ch98-1/Thermocouple-Data-Logger/README.md

# Thermocouple-Data-Logger
Thermocouple Data Logger using MAX31856 and ATmega324PA

Warning: Do not put this device anywhere near lawyers, as it may permanently cease to function if you do so.

**License**

All files are licensed under [zlib license](https://opensource.org/licenses/Zlib) unless noted otherwise.
KiCad Library Files (All .lib .dcm .bck and .pretty files in The Thermocouple-Data-Logger directory) are licensed under [KiCad Libraries License] (http://kicad-pcb.org/libraries/license/)
Petit FatFs Module (All files in /Firmware/pff3) is licensed under Petit FatFs License
