ch98-1/Thermocouple-Data-Logger/Thermocouple Data Logger.pdf

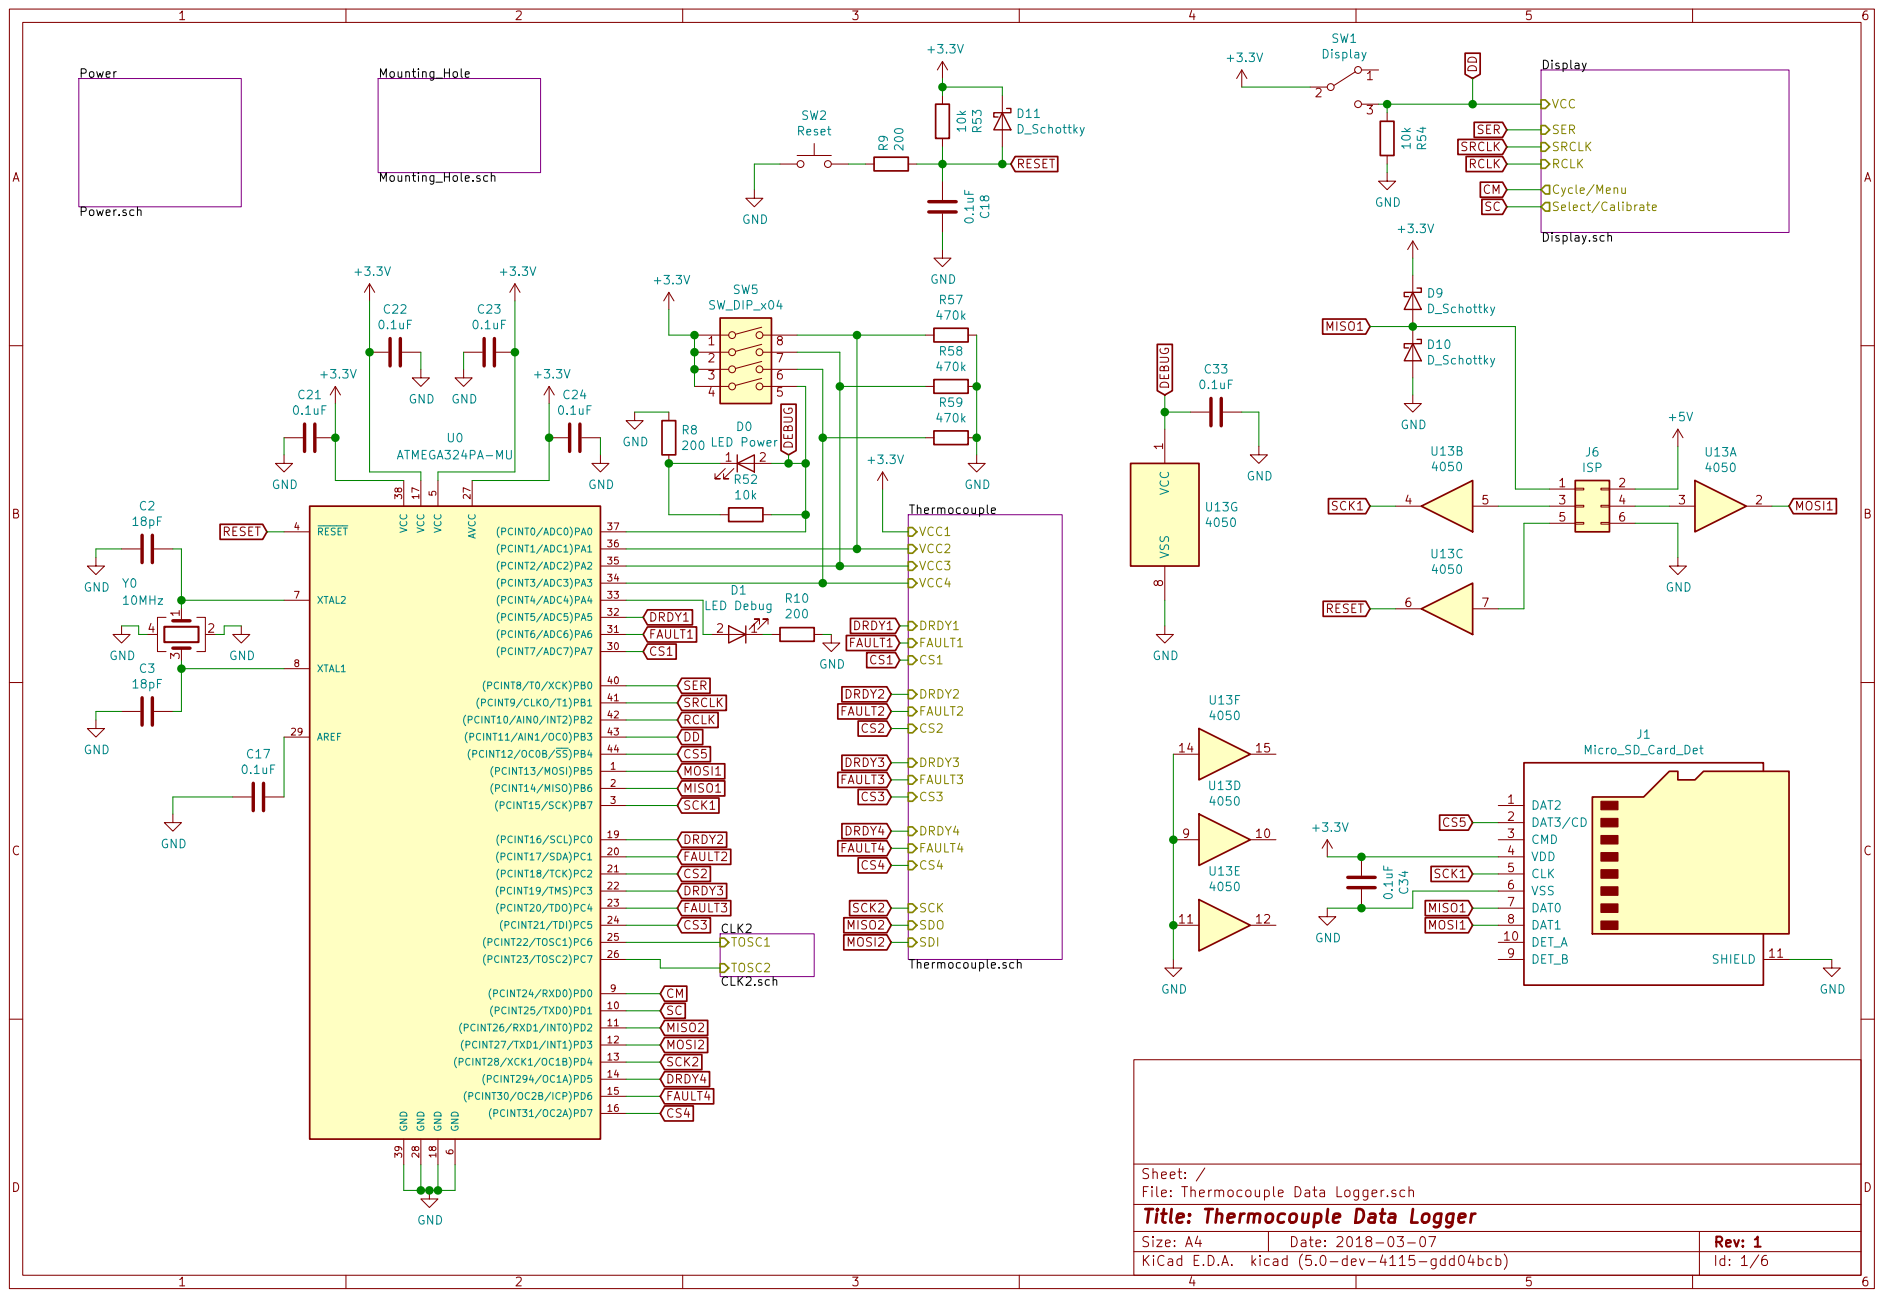
[picture p1: page 1]

SRCLK RCLK DD
Display.sch VCC
Select/Calibrate Cycle/Menu SER
SRCLK RCLK

File: Thermocouple Data Logger.sch Sheet: /
Id: 1/6 Title: Thermocouple Data Logger

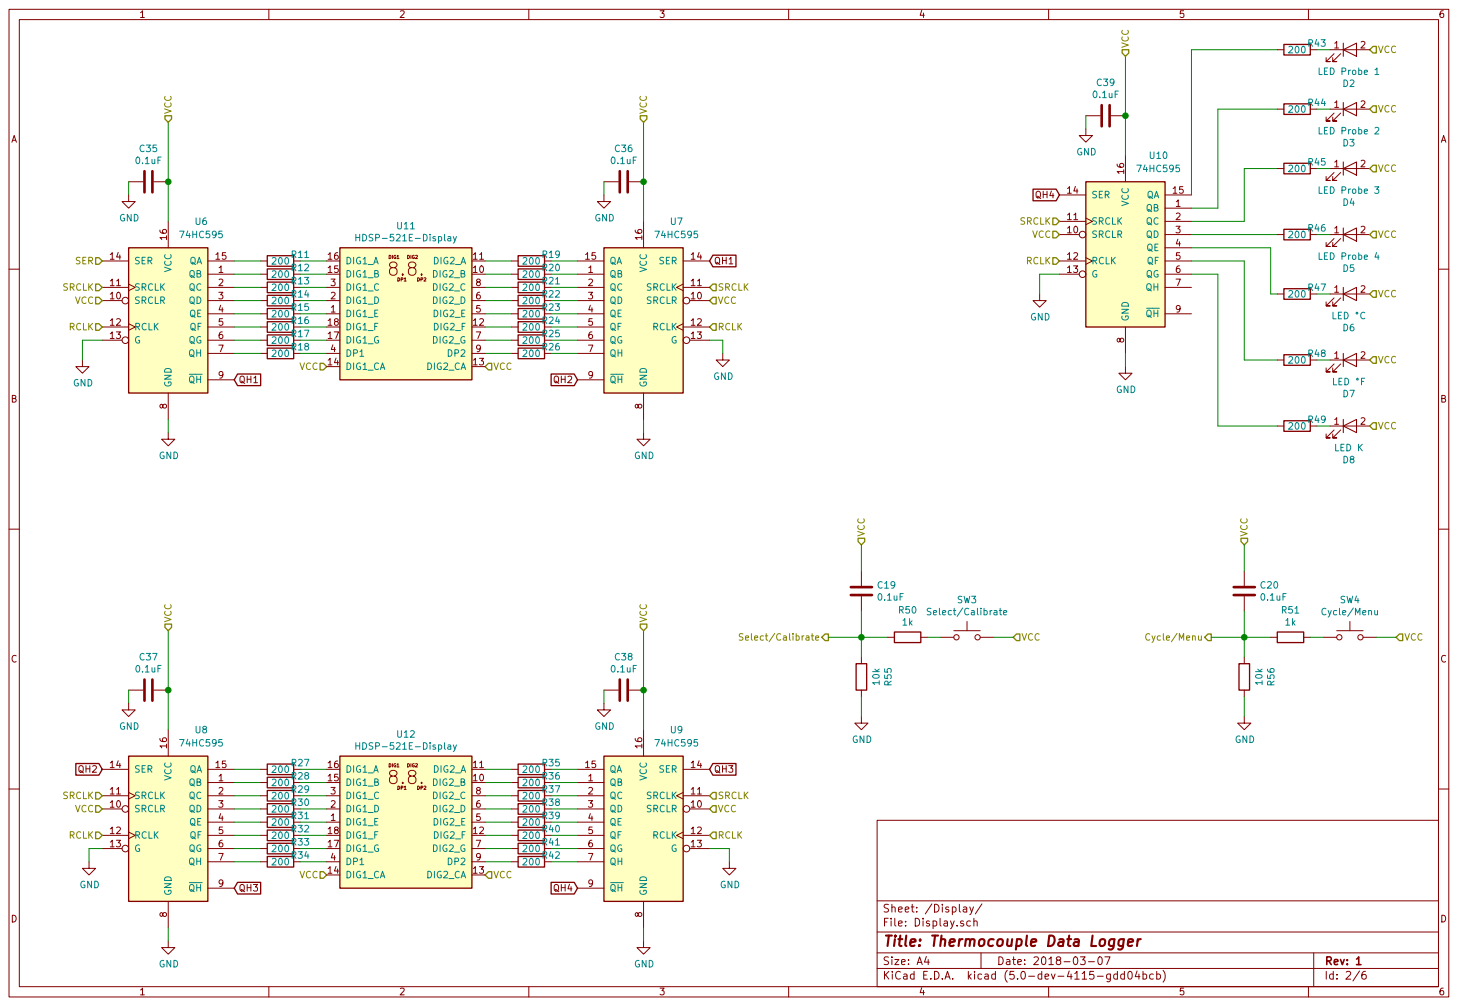
[picture p2: page 2]

8 QH 9 SRCLR 10 SRCLK 11 RCLK 12 G
VCC GND

Sheet: /Display/
File: Display.sch
Id: 2/6 Title: Thermocouple Data Logger

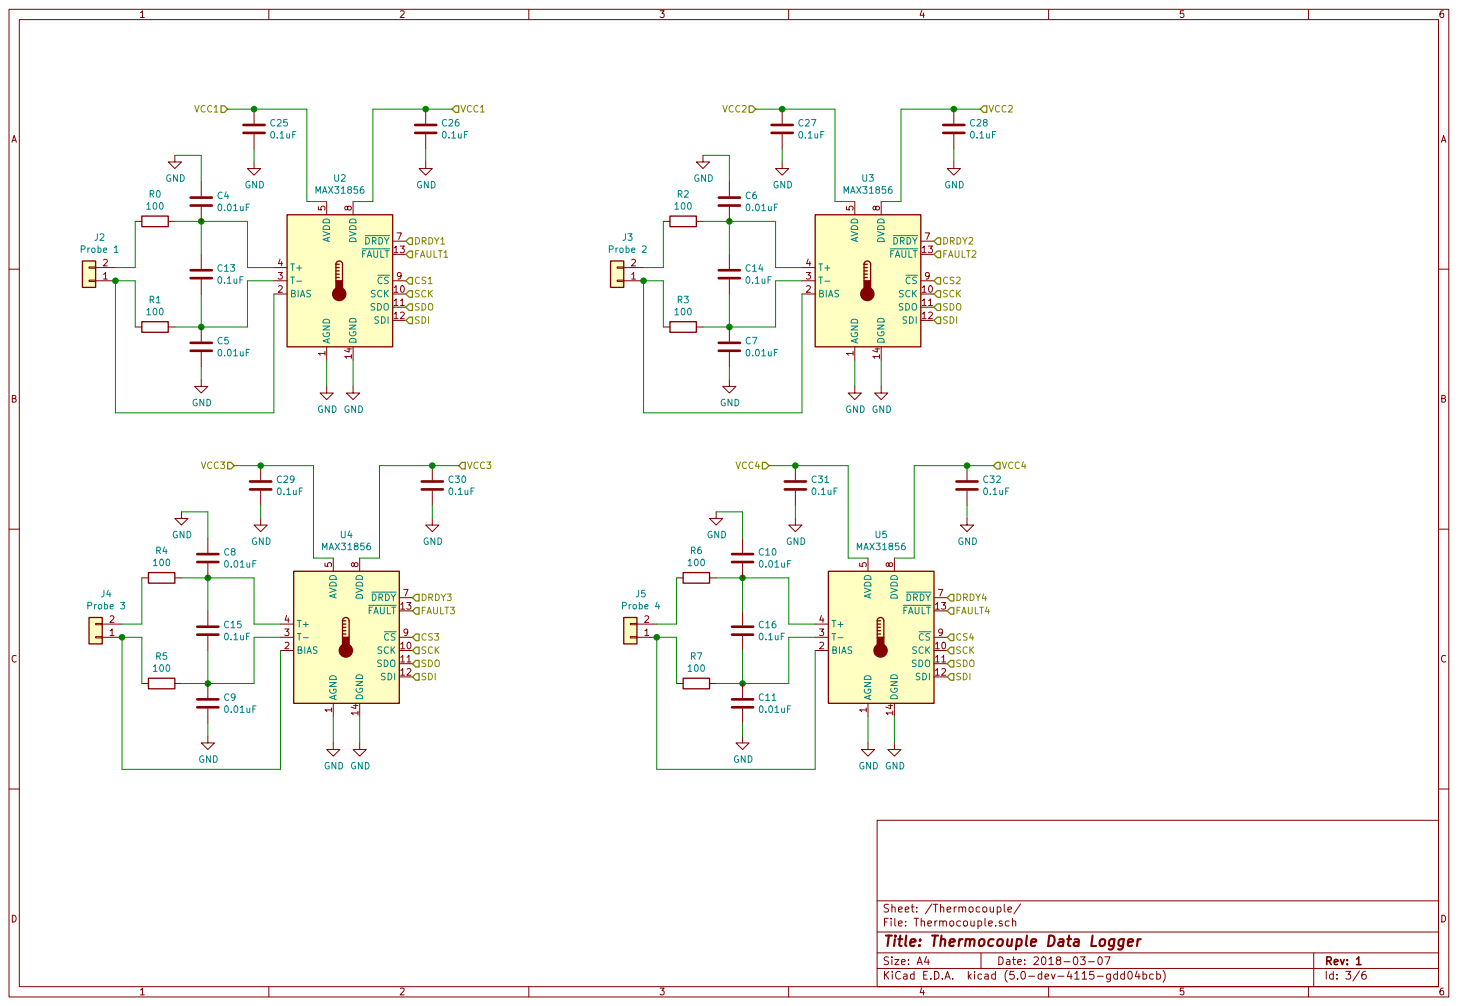
[picture p3: page 3]

8 CS 9 SCK 10 SDO 11 SDI 12 FAULT 13 DGND 14 U2 MAX31856 GND GND

8 CS 9 SCK 10 SDO 11 SDI 12 FAULT 13 DGND 14 U3 MAX31856 GND GND
SDI AGND

8 CS 9 SCK 10 SDO 11 SDI 12 FAULT 13 DGND 14 U4 MAX31856 GND GND

8 CS 9 SCK 10 SDO 11 SDI 12 FAULT 13 DGND 14 U5 MAX31856 GND GND

File: Thermocouple.sch
Id: 3/6 Title: Thermocouple Data Logger

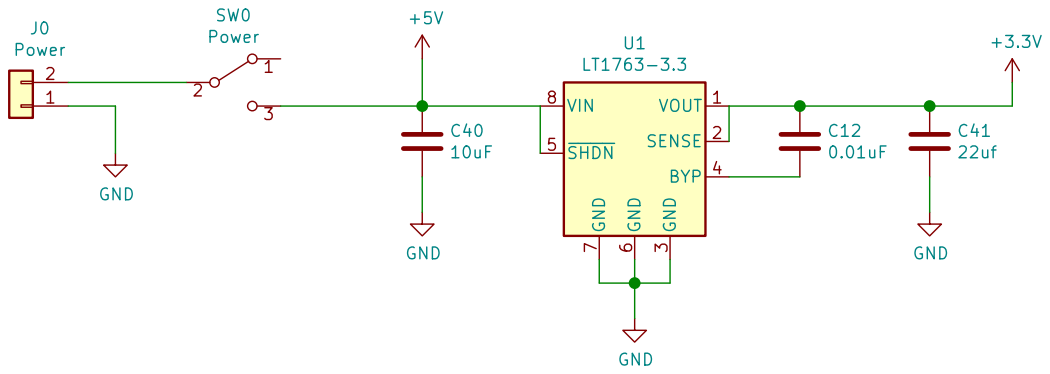
[picture p4: page 4]

Id: 4/6 Title: Thermocouple Data Logger File: Power.sch Sheet: /Power/

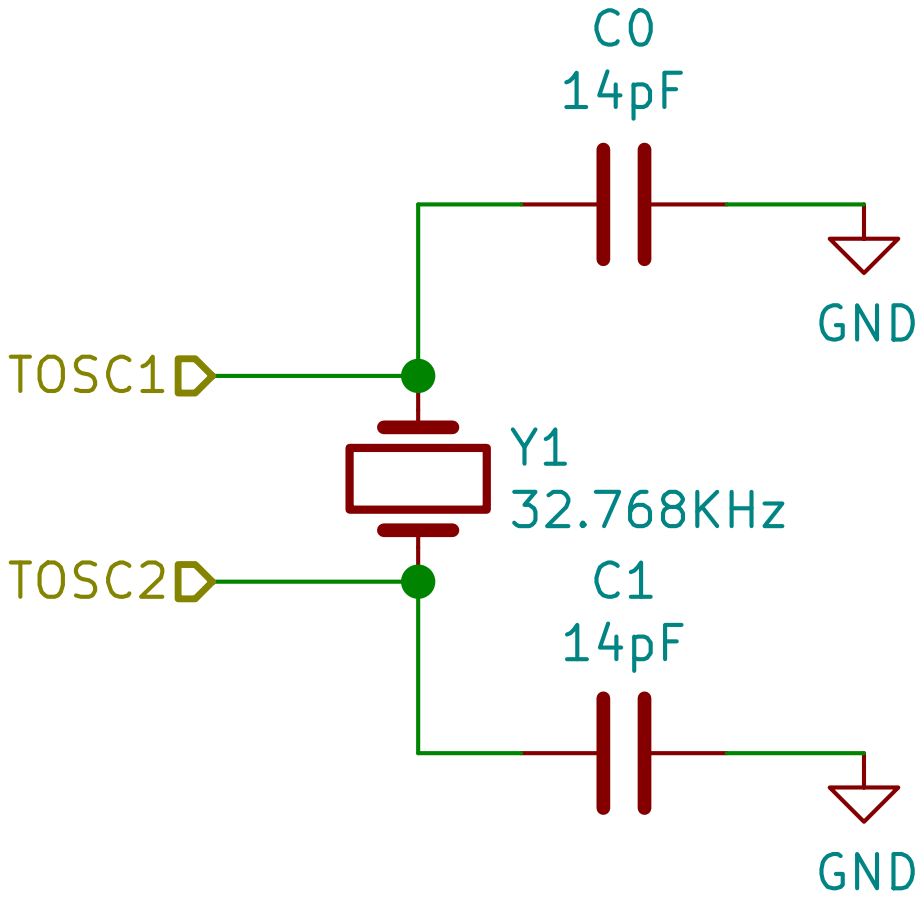
[picture p5: page 5]

Id: 5/6 Title: Thermocouple Data Logger File: CLK2.sch Sheet: /CLK2/

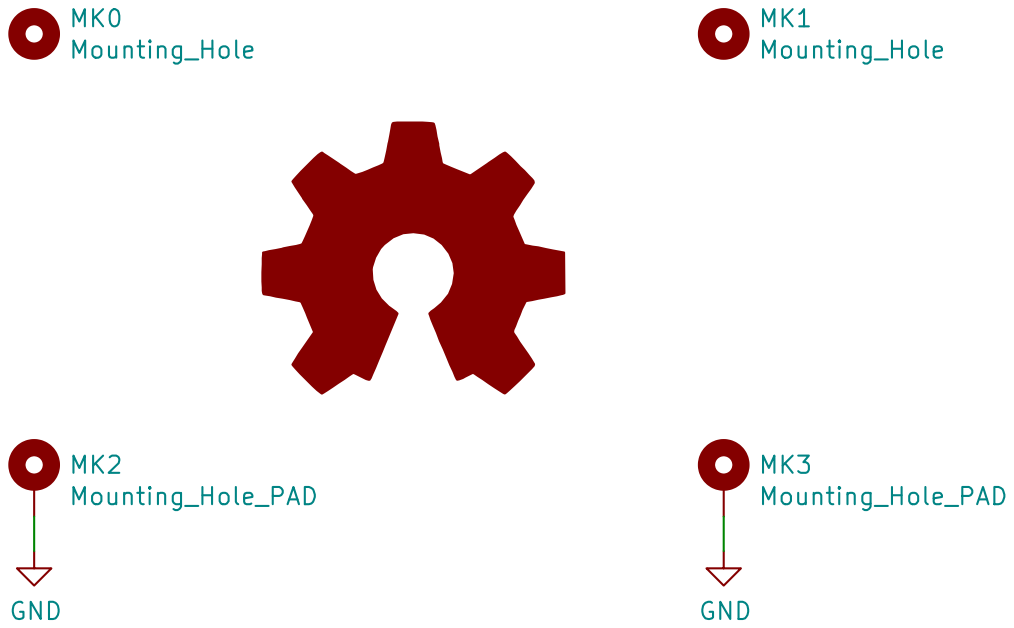
[picture p6: page 6]

File: Mounting_Hole.sch
Id: 6/6 Title: Thermocouple Data Logger
