ch98-1/Thermocouple-Data-Logger/Thermocouple-Data-Logger/Thermocouple Data Logger.kicad_pcb

## KiCad design Thermocouple-Data-Logger/Thermocouple Data Logger.kicad_pcb (2018-04-28)

Schematic: Thermocouple Data Logger.sch

Parts:
C2, C3: 18pF; C_0402
C17, C18, C21, C22, C23, C24, C33, C34: 0.1uF; C_0402
D0: LED Power; LED_0603
D1: LED Debug; LED_0603
D9, D10, D11: D_Schottky; D_SOD-323
J1: Micro_SD_Card_Det; Hirose_DM3BT-DSF-PEJS
J6: ISP; Pin_Header_Straight_2x03_Pitch2.54mm
R8, R9, R10: 200; R_0805
R52, R53, R54: 10k; R_0402
R57, R58, R59: 470k; R_0402
SW1: Display; SW_SPDT_CK-JS102011SAQN
SW2: Reset; SW_SPST_PTS645
SW5: SW_DIP_x04; SW_DIP_x4_W5.08mm_Slide_Copal_CHS-A
U0: ATMEGA324PA-MU; TQFP-44_10x10mm_Pitch0.8mm
U13: 4050; TSSOP-16_4.4x5mm_Pitch0.65mm
Y0: 10MHz; Crystal_SMD_Abracon_ABM3B-4pin_5.0x3.2mm

Connections:
+3V3: C21.1, C22.2, C23.1, C24.2, C34.2, D9.1 (K), D11.1 (K), J1.4 (VDD), R53.2, SW1.2, SW5.1, SW5.2, SW5.3, SW5.4, U0.5 (VCC), U0.17 (VCC), U0.27 (AVCC), U0.38 (VCC); also elsewhere on the board
+5V: J6.2; also elsewhere on the board
/CLK2/TOSC1: U0.25 ((PCINT22/TOSC1)PC6); also elsewhere on the board
/CLK2/TOSC2: U0.26 ((PCINT23/TOSC2)PC7); also elsewhere on the board
/Thermocouple/VCC2: R57.2, SW5.8, U0.36 ((PCINT1/ADC1)PA1); also elsewhere on the board
/Thermocouple/VCC3: R58.2, SW5.7, U0.35 ((PCINT2/ADC2)PA2); also elsewhere on the board
/Thermocouple/VCC4: R59.2, SW5.6, U0.34 ((PCINT3/ADC3)PA3); also elsewhere on the board
CM: U0.9 ((PCINT24/RXD0)PD0); also elsewhere on the board
CS1: U0.30 ((PCINT7/ADC7)PA7); also elsewhere on the board
CS2: U0.21 ((PCINT18/TCK)PC2); also elsewhere on the board
CS3: U0.24 ((PCINT21/TDI)PC5); also elsewhere on the board
CS4: U0.16 ((PCINT31/OC2A)PD7); also elsewhere on the board
CS5: J1.2 (DAT3/CD), U0.44 ((PCINT12/OC0B/~SS~)PB4)
DD: R54.2, SW1.3, U0.43 ((PCINT11/AIN1/OC0)PB3); also elsewhere on the board
DEBUG: C33.2, D0.2 (A), R52.1, SW5.5, U0.37 ((PCINT0/ADC0)PA0), U13.1 (VCC)
DRDY1: U0.32 ((PCINT5/ADC5)PA5); also elsewhere on the board
DRDY2: U0.19 ((PCINT16/SCL)PC0); also elsewhere on the board
DRDY3: U0.22 ((PCINT19/TMS)PC3); also elsewhere on the board
DRDY4: U0.14 ((PCINT294/OC1A)PD5); also elsewhere on the board
FAULT1: U0.31 ((PCINT6/ADC6)PA6); also elsewhere on the board
FAULT2: U0.20 ((PCINT17/SDA)PC1); also elsewhere on the board
FAULT3: U0.23 ((PCINT20/TDO)PC4); also elsewhere on the board
FAULT4: U0.15 ((PCINT30/OC2B/ICP)PD6); also elsewhere on the board
MISO1: D9.2 (A), D10.1 (K), J1.7 (DAT0), J6.1, U0.2 ((PCINT14/MISO)PB6)
MISO2: U0.11 ((PCINT26/RXD1/INT0)PD2); also elsewhere on the board
MOSI1: J1.8 (DAT1), U0.1 ((PCINT13/MOSI)PB5), U13.2
MOSI2: U0.12 ((PCINT27/TXD1/INT1)PD3); also elsewhere on the board
unnamed: C2.1, U0.7 (XTAL2), Y0.1
unnamed: C3.1, U0.8 (XTAL1), Y0.3
unnamed: C17.1, U0.29 (AREF)
unnamed: D0.1 (K), R8.2, R52.2
unnamed: D1.1 (K), R10.1
unnamed: D1.2 (A), U0.33 ((PCINT4/ADC4)PA4)
unnamed: J6.3, U13.5
unnamed: J6.4, U13.3
unnamed: J6.5, U13.7
unnamed: R9.1, SW2.2
RCLK: U0.42 ((PCINT10/AIN0/INT2)PB2); also elsewhere on the board
RESET: C18.2, D11.2 (A), R9.2, R53.1, U0.4 (~RESET), U13.6
SC: U0.10 ((PCINT25/TXD0)PD1); also elsewhere on the board
SCK1: J1.5 (CLK), U0.3 ((PCINT15/SCK)PB7), U13.4
SCK2: U0.13 ((PCINT28/XCK1/OC1B)PD4); also elsewhere on the board
SER: U0.40 ((PCINT8/T0/XCK)PB0); also elsewhere on the board
SRCLK: U0.41 ((PCINT9/CLKO/T1)PB1); also elsewhere on the board

Schematic: Display.sch, Thermocouple Data Logger

Parts:
C19, C20, C35, C36, C37, C38, C39: 0.1uF; C_0402
D2: LED Probe 1; LED_0603
D3: LED Probe 2; LED_0603
D4: LED Probe 3; LED_0603
D5: LED Probe 4; LED_0603
D6: LED °C; LED_0603
D7: LED °F; LED_0603
D8: LED K; LED_0603
R11, R12, R13, R14, R15, R16, R17, R18, R19, R20, R21, R22, R23, R24, R25, R26, R27, R28, R29, R30, R31, R32, R33, R34, R35, R36, R37, R38, R39, R40, R41, R42, R43, R44, R45, R46, R47, R48, R49: 200; R_0805
R50, R51: 1k; R_0402
R55, R56: 10k; R_0402
SW3: Select/Calibrate; SW_SPST_PTS645
SW4: Cycle/Menu; SW_SPST_PTS645
U6, U7, U8, U9, U10: 74HC595; TSSOP-16_4.4x5mm_Pitch0.65mm
U11, U12: HDSP-521E-Display; HDSP-521E

Connections:
CM: C20.2, R51.2, R56.2; also elsewhere on the board
DD: C19.1, C20.1, C35.1, C36.1, C37.1, C38.1, C39.1, D2.2 (A), D3.2 (A), D4.2 (A), D5.2 (A), D6.2 (A), D7.2 (A), D8.2 (A), SW3.2, SW4.2, U6.10 (SRCLR), U6.16 (VCC), U7.10 (SRCLR), U7.16 (VCC), U8.10 (SRCLR), U8.16 (VCC), U9.10 (SRCLR), U9.16 (VCC), U10.10 (SRCLR), U10.16 (VCC), U11.13, U11.14, U12.13, U12.14; also elsewhere on the board
unnamed: D2.1 (K), R43.1
unnamed: D3.1 (K), R44.1
unnamed: D4.1 (K), R45.1
unnamed: D5.1 (K), R46.1
unnamed: D6.1 (K), R47.1
unnamed: D7.1 (K), R48.1
unnamed: D8.1 (K), R49.1
unnamed: R11.1, U11.16
unnamed: R11.2, U6.15 (QA)
unnamed: R12.1, U11.15
unnamed: R12.2, U6.1 (QB)
unnamed: R13.1, U11.3
unnamed: R13.2, U6.2 (QC)
unnamed: R14.1, U11.2
unnamed: R14.2, U6.3 (QD)
unnamed: R15.1, U11.1
unnamed: R15.2, U6.4 (QE)
unnamed: R16.1, U11.18
unnamed: R16.2, U6.5 (QF)
unnamed: R17.1, U11.17
unnamed: R17.2, U6.6 (QG)
unnamed: R18.1, U11.4
unnamed: R18.2, U6.7 (QH)
unnamed: R19.1, U7.15 (QA)
unnamed: R19.2, U11.11
unnamed: R20.1, U7.1 (QB)
unnamed: R20.2, U11.10
unnamed: R21.1, U7.2 (QC)
unnamed: R21.2, U11.8
unnamed: R22.1, U7.3 (QD)
unnamed: R22.2, U11.6
unnamed: R23.1, U7.4 (QE)
unnamed: R23.2, U11.5
unnamed: R24.1, U7.5 (QF)
unnamed: R24.2, U11.12
unnamed: R25.1, U7.6 (QG)
unnamed: R25.2, U11.7
unnamed: R26.1, U7.7 (QH)
unnamed: R26.2, U11.9
unnamed: R27.1, U12.16
unnamed: R27.2, U8.15 (QA)
unnamed: R28.1, U12.15
unnamed: R28.2, U8.1 (QB)
unnamed: R29.1, U12.3
unnamed: R29.2, U8.2 (QC)
unnamed: R30.1, U12.2
unnamed: R30.2, U8.3 (QD)
unnamed: R31.1, U12.1
unnamed: R31.2, U8.4 (QE)
unnamed: R32.1, U12.18
unnamed: R32.2, U8.5 (QF)
unnamed: R33.1, U12.17
unnamed: R33.2, U8.6 (QG)
unnamed: R34.1, U12.4
unnamed: R34.2, U8.7 (QH)
unnamed: R35.1, U9.15 (QA)
unnamed: R35.2, U12.11
unnamed: R36.1, U9.1 (QB)
unnamed: R36.2, U12.10
unnamed: R37.1, U9.2 (QC)
unnamed: R37.2, U12.8
unnamed: R38.1, U9.3 (QD)
unnamed: R38.2, U12.6
unnamed: R39.1, U9.4 (QE)
unnamed: R39.2, U12.5
unnamed: R40.1, U9.5 (QF)
unnamed: R40.2, U12.12
unnamed: R41.1, U9.6 (QG)
unnamed: R41.2, U12.7
unnamed: R42.1, U9.7 (QH)
unnamed: R42.2, U12.9
unnamed: R43.2, U10.15 (QA)
unnamed: R44.2, U10.1 (QB)
unnamed: R45.2, U10.2 (QC)
unnamed: R46.2, U10.3 (QD)
unnamed: R47.2, U10.4 (QE)
unnamed: R48.2, U10.5 (QF)
unnamed: R49.2, U10.6 (QG)
unnamed: R50.1, SW3.1
unnamed: R51.1, SW4.1
QH1: U6.9 (~QH), U7.14 (SER)
QH2: U7.9 (~QH), U8.14 (SER)
QH3: U8.9 (~QH), U9.14 (SER)
QH4: U9.9 (~QH), U10.14 (SER)
RCLK: U6.12 (RCLK), U7.12 (RCLK), U8.12 (RCLK), U9.12 (RCLK), U10.12 (RCLK); also elsewhere on the board
SC: C19.2, R50.2, R55.2; also elsewhere on the board
SER: U6.14 (SER); also elsewhere on the board
SRCLK: U6.11 (SRCLK), U7.11 (SRCLK), U8.11 (SRCLK), U9.11 (SRCLK), U10.11 (SRCLK); also elsewhere on the board

Schematic: Thermocouple.sch, Thermocouple Data Logger

Parts:
C4, C5, C6, C7, C8, C9, C10, C11: 0.01uF; C_0402
C13, C14, C15, C16: 0.1uF; C_0805
C25, C26, C27, C28, C29, C30, C31, C32: 0.1uF; C_0402
J2: Probe 1; TeaminalBlock_Phonix_PTSA-3.5mm_2pol
J3: Probe 2; TeaminalBlock_Phonix_PTSA-3.5mm_2pol
J4: Probe 3; TeaminalBlock_Phonix_PTSA-3.5mm_2pol
J5: Probe 4; TeaminalBlock_Phonix_PTSA-3.5mm_2pol
R0, R1, R2, R3, R4, R5, R6, R7: 100; R_0603
U2, U3, U4, U5: MAX31856; TSSOP-14_4.4x5mm_Pitch0.65mm

Connections:
+3V3: C25.1, C26.1, U2.5 (AVDD), U2.8 (DVDD); also elsewhere on the board
/Thermocouple/VCC2: C27.1, C28.1, U3.5 (AVDD), U3.8 (DVDD); also elsewhere on the board
/Thermocouple/VCC3: C29.1, C30.1, U4.5 (AVDD), U4.8 (DVDD); also elsewhere on the board
/Thermocouple/VCC4: C31.1, C32.1, U5.5 (AVDD), U5.8 (DVDD); also elsewhere on the board
CS1: U2.9 (~CS); also elsewhere on the board
CS2: U3.9 (~CS); also elsewhere on the board
CS3: U4.9 (~CS); also elsewhere on the board
CS4: U5.9 (~CS); also elsewhere on the board
DRDY1: U2.7 (~DRDY); also elsewhere on the board
DRDY2: U3.7 (~DRDY); also elsewhere on the board
DRDY3: U4.7 (~DRDY); also elsewhere on the board
DRDY4: U5.7 (~DRDY); also elsewhere on the board
FAULT1: U2.13 (~FAULT); also elsewhere on the board
FAULT2: U3.13 (~FAULT); also elsewhere on the board
FAULT3: U4.13 (~FAULT); also elsewhere on the board
FAULT4: U5.13 (~FAULT); also elsewhere on the board
MISO2: U2.11 (SDO), U3.11 (SDO), U4.11 (SDO), U5.11 (SDO); also elsewhere on the board
MOSI2: U2.12 (SDI), U3.12 (SDI), U4.12 (SDI), U5.12 (SDI); also elsewhere on the board
unnamed: C10.2, C16.1, R6.1, U5.4 (T+)
unnamed: C11.1, C16.2, R7.1, U5.3 (T-)
unnamed: C4.2, C13.1, R0.1, U2.4 (T+)
unnamed: C5.1, C13.2, R1.1, U2.3 (T-)
unnamed: C6.2, C14.1, R2.1, U3.4 (T+)
unnamed: C7.1, C14.2, R3.1, U3.3 (T-)
unnamed: C8.2, C15.1, R4.1, U4.4 (T+)
unnamed: C9.1, C15.2, R5.1, U4.3 (T-)
unnamed: J2.1, R1.2, U2.2 (BIAS)
unnamed: J2.2, R0.2
unnamed: J3.1, R3.2, U3.2 (BIAS)
unnamed: J3.2, R2.2
unnamed: J4.1, R5.2, U4.2 (BIAS)
unnamed: J4.2, R4.2
unnamed: J5.1, R7.2, U5.2 (BIAS)
unnamed: J5.2, R6.2
SCK2: U2.10 (SCK), U3.10 (SCK), U4.10 (SCK), U5.10 (SCK); also elsewhere on the board

Schematic: Power.sch, Thermocouple Data Logger

Parts:
C12: 0.01uF; C_0402
C40: 10uF; C_1210
C41: 22uf; C_1206
J0: Power; JST_PH_S2B-PH-SM4-TB_02x2.00mm_Angled
SW0: Power; SW_SPDT_CK-JS102011SAQN
U1: LT1763-3.3; SOIC-8_3.9x4.9mm_Pitch1.27mm

Connections:
+3V3: C12.1, C41.1, U1.1, U1.2; also elsewhere on the board
+5V: C40.1, SW0.3, U1.5, U1.8; also elsewhere on the board
unnamed: C12.2, U1.4
unnamed: J0.2, SW0.2

Schematic: CLK2.sch, Thermocouple Data Logger

Parts:
C0, C1: 14pF; C_0402
Y1: 32.768KHz; Crystal_DS26_d2.0mm_l6.0mm_Horizontal

Connections:
/CLK2/TOSC1: C0.1, Y1.1; also elsewhere on the board
/CLK2/TOSC2: C1.2, Y1.2; also elsewhere on the board

Schematic: Mounting_Hole.sch, Thermocouple Data Logger

Parts:
MK0, MK1: Mounting_Hole; MountingHole_3.2mm_M3
MK2, MK3: Mounting_Hole_PAD; MountingHole_3.2mm_M3_Pad_Via

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
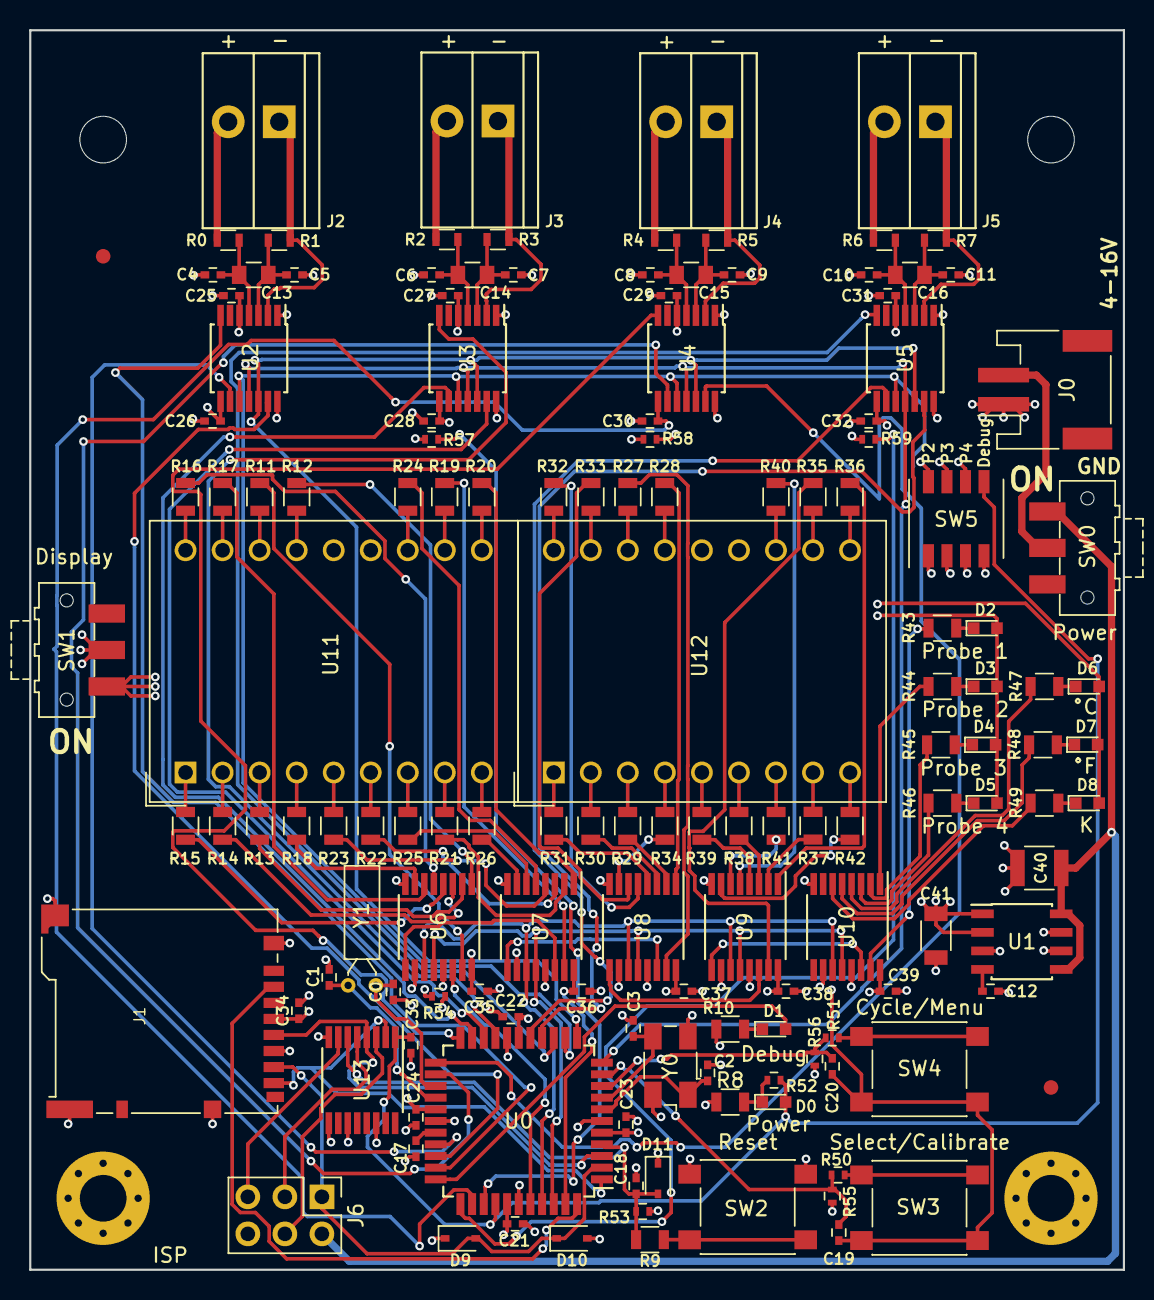
[picture p7: board Thermocouple Data Logger.kicad_pcb from above]

Board: 4 copper layers, 75.0 x 85.0 mm, 147 parts (0 on the bottom side), 147 nets.
