ch98-1/Thermocouple-Data-Logger/(commit log)

2018-02-15 Created Project Files
    [Thermocouple Data Logger.kicad_pcb, Thermocouple Data Logger.sch]
2018-02-16 Changed Voltage Regulator
    [Display.sch, Thermocouple Data Logger.sch]
2018-02-22 More components
    [Display.sch, Power.sch, Thermocouple Data Logger.sch, Thermocouple.sch]
2018-02-23 Changed folder name
    [Display.sch, Power.sch, Thermocouple Data Logger.kicad_pcb, Thermocouple Data Logger.sch, Thermocouple.sch]
2018-02-27 Added a lot more to the schimatic
    [Power.sch, Thermocouple Data Logger.sch, Thermocouple.sch]
2018-02-27 Added the thermocouple module.
    [CLK2.sch, Display.sch, Power.sch, Thermocouple Data Logger.sch, Thermocouple.sch]
2018-02-27 Added switches
    [Display.sch, Power.sch, Thermocouple Data Logger.sch, Thermocouple.sch]
2018-02-28 Finished basic schimatic layout
    [Display.sch, Thermocouple Data Logger.sch]
2018-02-28 Updated SD card slot to generic
    [Thermocouple Data Logger.sch]
2018-02-28 Annotated schematic
    [CLK2.sch, Display.sch, Power.sch, Thermocouple Data Logger.sch, Thermocouple.sch]
2018-02-28 Renamed some components
    [Display.sch, Thermocouple Data Logger.sch, Thermocouple.sch]
2018-02-28 Made footprint for the terminal block
    [CLK2.sch, Display.sch, Power.sch, Thermocouple Data Logger.sch, Thermocouple.sch]
2018-03-01 Added the components and generaterd the netlist
    [CLK2.sch, Display.sch, Power.sch, Thermocouple Data Logger.sch, Thermocouple.sch]
2018-03-01 Started pcb design
    [Display.sch]
2018-03-01 Imported all the parts
    [Thermocouple Data Logger.kicad_pcb]
2018-03-01 Started laying out components
    [Thermocouple Data Logger.kicad_pcb]
2018-03-02 Made thermocouple input layout
    [Thermocouple Data Logger.kicad_pcb]
2018-03-02 Added mounting holes, grounding holes and fiducials
    [CLK2.sch, Display.sch, Mounting_Hole.sch, Power.sch, Thermocouple Data Logger.kicad_pcb, Thermocouple Data Logger.sch, Thermocouple.sch]
2018-03-03 Finished general layout of large components
    [Mounting_Hole.sch, Thermocouple Data Logger.kicad_pcb]
2018-03-06 Changed capacitor values and component layout
    [Display.sch, Mounting_Hole.sch, Thermocouple Data Logger.kicad_pcb, Thermocouple Data Logger.sch, Thermocouple.sch]
2018-03-06 Started laying down traces
    [Display.sch, Thermocouple Data Logger.kicad_pcb]
2018-03-06 Finished routing all traces
    [Thermocouple Data Logger.kicad_pcb, Thermocouple Data Logger.sch]
2018-03-06 Centerd board and generated gerber for test view
    [Thermocouple Data Logger.kicad_pcb]
2018-03-06 Actually generated gerber
    [Thermocouple Data Logger-B.Cu.gbr, Thermocouple Data Logger-B.Mask.gbr, Thermocouple Data Logger-B.Paste.gbr, Thermocouple Data Logger-B.SilkS.gbr, Thermocouple Data Logger-Edge.Cuts.gbr, Thermocouple Data Logger-F.Cu.gbr, Thermocouple Data Logger-F.Mask.gbr, Thermocouple Data Logger-F.Paste.gbr]
2018-03-07 Satrted Labling the Components
    [Mounting_Hole.sch, Thermocouple Data Logger.kicad_pcb]
2018-03-07 Finished labling the board. Ver 1 hardware
    [CLK2.sch, Display.sch, Mounting_Hole.sch, Power.sch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]
2018-03-07 Refilled planes and generated new gerber files
    [Thermocouple Data Logger-B.Cu.gbr, Thermocouple Data Logger-B.Mask.gbr, Thermocouple Data Logger-B.Paste.gbr, Thermocouple Data Logger-B.SilkS.gbr, Thermocouple Data Logger-Edge.Cuts.gbr, Thermocouple Data Logger-F.Cu.gbr, Thermocouple Data Logger-F.Mask.gbr, Thermocouple Data Logger-F.Paste.gbr]
2018-03-08 Generated the BOM from digikey
    [Bom_Digikey.csv]
2018-03-13 Updated components to something still in stock
    [Bom_Digikey.csv]
2018-03-20 Fixed some silkscreen and added init source file
    [Thermocouple Data Logger-B.Cu.gbr, Thermocouple Data Logger-B.Mask.gbr, Thermocouple Data Logger-B.Paste.gbr, Thermocouple Data Logger-B.SilkS.gbr, Thermocouple Data Logger-Edge.Cuts.gbr, Thermocouple Data Logger-F.Cu.gbr, Thermocouple Data Logger-F.Mask.gbr, Thermocouple Data Logger-F.Paste.gbr]
2018-03-23 Added more test code
    [Thermocouple Data Logger-B.Cu.gbr, Thermocouple Data Logger-B.Mask.gbr, Thermocouple Data Logger-B.Paste.gbr, Thermocouple Data Logger-B.SilkS.gbr, Thermocouple Data Logger-Edge.Cuts.gbr, Thermocouple Data Logger-F.Cu.gbr, Thermocouple Data Logger-F.Mask.gbr, Thermocouple Data Logger-F.Paste.gbr]
2018-04-28 Changed the microcontroller from qfn to tqfp
    [Bom_Digikey.csv, CLK2.sch, Display.sch, Power.sch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]
