ch98-1/Thermocouple-Data-Logger/(notices)

Notices in the files:
Thermocouple-Data-Logger/Thermocouple Data Logger.kicad_pcb:
(c) 2018 Corwin Hansen
